neilspink/mood-barometer/README.md

# Arduino mood barometer with ESP32

This project implements an analog display that gets its data from an [MQTT broker](http://mqtt.org/). 

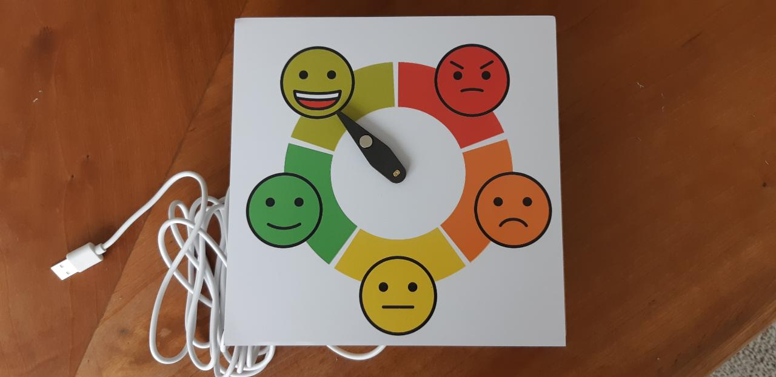
[picture p1: picture-front.jpg]
Mood Barometer Front


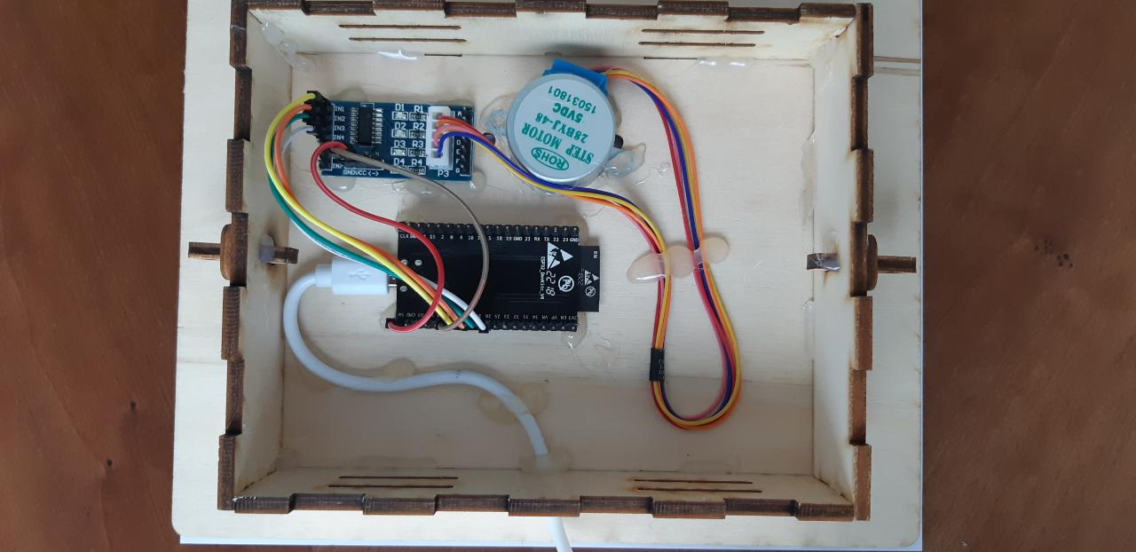
[picture p2: picture-back.jpg]
Mood Barometer Back


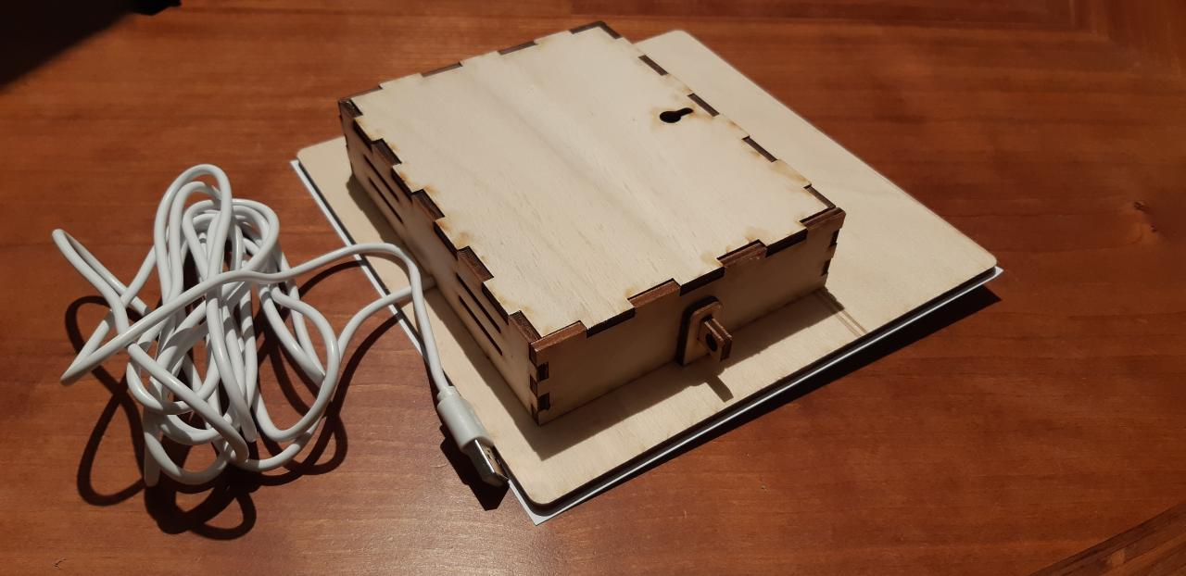
[picture p3: picture-back-cover.jpg]
Mood Barometer Back


Download link for construction of the housing in Fusion 360

http://a360.co/2nmHa7m

The ESP32 development board I used features a built-in hall effect sensor, it detects changes in the magnetic field in its surroundings, i.e. the magnet mounted on the clock-arm. 

The idea and housing came from a [blog post](https://www.bastelgarage.ch/index.php?route=extension/d_blog_module/post&post_id=10) on a Swiss onlineshop for DIY electronics [www.bastelgarage.ch](www.bastelgarage.ch). 

## Components

* NodeMCU-32S ESP32 WiFi Bluetooth development board https://docs.espressif.com/projects/esp-idf/en/latest/esp32/_images/esp32-devkitC-v4-pinout.png
* Stepper motor 28BYJ-28 with a ULN2003 driver board
* 6x10mm neodymium bar magnet
* https://github.com/neilspink/SRE-IoT-Demoboard

## Clock Face

The smileys I got from https://openmoji.org/

I created it using the [GIMP](https://www.gimp.org/), the XCF file is included in the repository.

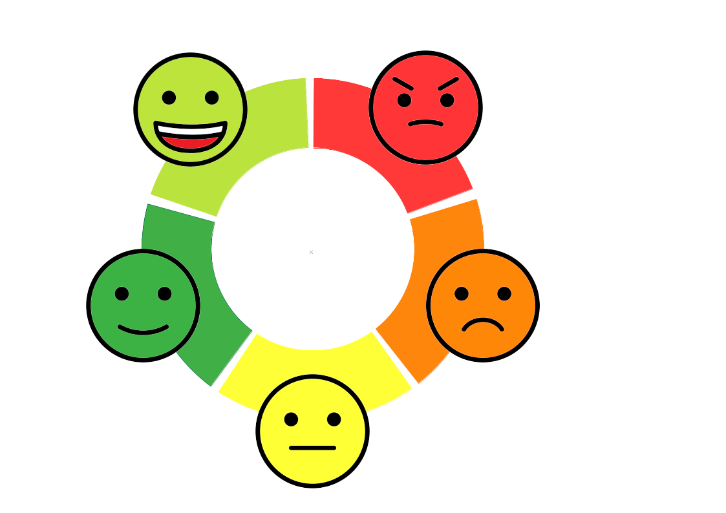
[picture p4: dial.png]
Mood Dial
